DHard4114/DESPRO-4/management/reports/individual/raka/WEEK_01_INDIVIDUAL_RAKA.md

# LAPORAN PEKANAN INDIVIDU — RAKA ARRAYAN MUTTAQIEN (PEKAN 1)
## Despro 2 Smart-Sanitation eSOS

Status Dokumen: TEMPLATE TERKENDALI (CONTROLLED TEMPLATE)  
Nama Mahasiswa: Raka Arrayan Muttaqien  
NPM: 2306161800  
Peran Proposal: Analis Solusi dan Integrasi Layanan (Alokasi: 35 Jam)  
Kelompok: 4 (Empat) | Pekan: 1 (Satu) | Periode: 26 Agustus 2026 – 01 September 2026  
Dosen Pembimbing: Prof. Dr. Muhammad Suryanegara, S.T., M.Sc.  

---

### A. IDENTITAS
- **Judul Proyek:** Rancang Bangun Sistem Monitoring Smart-Sanitation eSOS Berbasis IoT untuk Wilayah Blank Spot Pasca-Bencana
- **Kelompok:** 4 (Empat)
- **Pekan Pelaksanaan:** Pekan 1 (Satu)
- **Periode Waktu:** 26 Agustus 2026 – 01 September 2026
- **Dosen Pembimbing:** Prof. Dr. Muhammad Suryanegara, S.T., M.Sc.

---

### B. TARGET MINGGUAN (PEKAN 1)
- Meninjau spesifikasi teknis proposal DP1 yang terkait domain solusi dan analisis kebutuhan.
- Melakukan verifikasi silang terhadap 15 komponen BoM proposal dan memeriksa ketersediaan pasar.
- Mengidentifikasi variansi harga sensor gas MQ-137/MQ-136 dan menyusun format perbandingan vendor.
- Menyusun dokumen pelacak pengadaan awal (`02_BOM_PROCUREMENT.md`).

---

### C. LOGBOOK AKTIVITAS HARIAN (PEKAN 1: 18.0 JAM)
| Hari / Tanggal | Uraian Aktivitas Operasional | Luaran yang Dihasilkan | ID Bukti | Jam Kerja |
|:---|:---|:---|:---:|:---:|
| Rabu, 26 Agt 2026 | Penelaahan kebutuhan sistem eSOS & standar sanitasi darurat | Dokumen analisis kebutuhan | EV-W1-SA-001 | 3.5 |
| Kamis, 27 Agt 2026 | Verifikasi silang 15 item BoM proposal terhadap katalog pasar | Tabel verifikasi BoM | EV-W1-SA-001 | 4.0 |
| Jumat, 28 Agt 2026 | Identifikasi deviasi harga sensor gas MQ-137 dan MQ-136 | Laporan variansi harga sensor | EV-W1-SA-002 | 3.5 |
| Sabtu, 29 Agt 2026 | Komparasi vendor e-commerce (Shopee/Tokopedia) & seleksi toko | Matriks evaluasi vendor | EV-W1-SA-001 | 3.5 |
| Senin, 31 Agt 2026 | Penyusunan lembar pelacak pengadaan dan persiapan Gate 1 | Dokumen `02_BOM_PROCUREMENT.md` | EV-W1-SA-001 | 3.5 |
| **TOTAL PEKAN 1** | | | | **18.0 Jam** |

---

### D. REALISASI PEKERJAAN
| Kode Tugas | Target Spesifikasi | Realisasi Teknis yang Diselesaikan | Status | ID Bukti |
|:---|:---|:---|:---:|:---:|
| **W1-SA-01** | Analisis kebutuhan sistem | Pemetaan standar sanitasi darurat dan batasan operasional tuntas | `DONE` | EV-W1-SA-001 |
| **W1-SA-03** | Verifikasi silang BoM | 15 item BoM proposal diverifikasi spesifikasi dan fungsinya | `DONE` | EV-W1-SA-001 |
| **W1-SA-05** | Mitigasi risiko pengadaan | Protokol `GATE-PROC-01` s.d. `GATE-PROC-05` ditetapkan | `DONE` | EV-W1-SA-001 |
| **W1-SA-08** | Pelacak pengadaan BoM | Dokumen BoM & tracker terintegrasi dengan batas pagu Rp2.000.000 | `DONE` | EV-W1-SA-001 |

---

### E. CAPAIAN TEKNIS MINGGUAN
- **Luaran Utama:** Dokumen `02_BOM_PROCUREMENT.md` terkunci dan draf Requirements Traceability Matrix (RTM).
- **Rincian Teknis:** Berhasil memetakan kebutuhan 15 komponen fisik, mengidentifikasi vendor terverifikasi, dan menetapkan protokol gerbang teknis kritis sebelum checkout untuk mencegah kesalahan spesifikasi.
- **Penerimaan Teknis:** Dokumen BoM dan RTM disetujui pada evaluasi Phase Gate 1 (PASS).

---

### F. PERMASALAHAN, KENDALA & G. TINDAKAN KOREKTIF
- **Kendala:** Harga pasar riil sensor gas MQ-137 terpantau berada di atas pagu alokasi awal proposal.
- **Tindakan Korektif:** Melakukan survei ke berbagai distributor komponen industri dan memanfaatkan penghematan pada item wiring untuk menjaga total anggaran tetap di bawah batas pagu Rp2.000.000.
- **Hasil:** Struktur pembiayaan aman dan tidak terjadi defisit anggaran.

---

### H. DOKUMENTASI & I. KONTRIBUSI TIM
- **Bukti Terkait:** `EV-W1-SA-001`, `EV-W1-SA-002`, `EV-W1-SA-003`.
- **Kontribusi:** Memastikan kelayakan solusi dan mempersiapkan rantai pasok komponen untuk eksekusi pengadaan Pekan 2.

---

### J. EVALUASI DIRI (SKOR: 25/25 POIN)
- Kehadiran (5/5), Jam Kerja 18h (5/5), Kontribusi Teknis (5/5), Kerja Sama (5/5), Profesionalisme (5/5).

---

### K. RENCANA PEKAN BERIKUTNYA (PEKAN 2)
- Eksekusi pembelian 15 item BoM, verifikasi kedatangan fisik di lab, pengumpulan faktur/resi, dan pembuatan buku aset.

---

### L. PERSETUJUAN
- **Mahasiswa:** Raka Arrayan Muttaqien *(Tanda Tangan)* — Tanggal: 01 September 2026
- **Ketua Kelompok:** Daffa Hardhan *(Tanda Tangan)* — Tanggal: 01 September 2026
- **Dosen Pembimbing:** Prof. Dr. Muhammad Suryanegara, S.T., M.Sc.
