DHard4114/DESPRO-4/management/reports/individual/raka/WEEK_02_INDIVIDUAL_RAKA.md

# LAPORAN PEKANAN INDIVIDU — RAKA ARRAYAN MUTTAQIEN (PEKAN 2)
## Despro 2 Smart-Sanitation eSOS

Status Dokumen: TEMPLATE TERKENDALI (CONTROLLED TEMPLATE)  
Nama Mahasiswa: Raka Arrayan Muttaqien  
NPM: 2306161800  
Peran Proposal: Analis Solusi dan Integrasi Layanan (Alokasi: 35 Jam)  
Kelompok: 4 (Empat) | Pekan: 2 (Dua) | Periode: 02 September 2026 – 08 September 2026  
Dosen Pembimbing: Prof. Dr. Muhammad Suryanegara, S.T., M.Sc.  

---

### A. IDENTITAS
- **Judul Proyek:** Rancang Bangun Sistem Monitoring Smart-Sanitation eSOS Berbasis IoT untuk Wilayah Blank Spot Pasca-Bencana
- **Kelompok:** 4 (Empat)
- **Pekan Pelaksanaan:** Pekan 2 (Dua)
- **Periode Waktu:** 02 September 2026 – 08 September 2026
- **Dosen Pembimbing:** Prof. Dr. Muhammad Suryanegara, S.T., M.Sc.

---

### B. TARGET MINGGUAN (PEKAN 2)
- Mengeksekusi pengadaan 15 komponen BoM resmi selama jendela pengadaan (31 Agt – 05 Sep 2026).
- Mengumpulkan datasheet resmi pabrikan untuk seluruh komponen kritis (ESP32, JSN-SR04T, MQ-137/136, LoRa, 18650).
- Memverifikasi kedatangan fisik barang di laboratorium dan mencatat kuitansi/faktur resmi.
- Membuat buku register aset inventaris proyek dan menyerahkan komponen ke Acceptance Owner.

---

### C. LOGBOOK AKTIVITAS HARIAN (PEKAN 2: 17.0 JAM)
| Hari / Tanggal | Uraian Aktivitas Operasional | Luaran yang Dihasilkan | ID Bukti | Jam Kerja |
|:---|:---|:---|:---:|:---:|
| Rabu, 02 Sep 2026 | Penguncian BoM, pengunduhan datasheet resmi komponen kritis | Arsip PDF datasheet komponen | EV-W1-SA-002 | 3.5 |
| Kamis, 03 Sep 2026 | Eksekusi pesanan komponen kritis (ESP32, sensor, LoRa, modul daya) | Bukti checkout & faktur invoice | EV-W2-PROC-001 | 4.0 |
| Jumat, 04 Sep 2026 | Koordinasi keputusan kapasitas solar panel (10Wp) bersama Ilman | Catatan keputusan solar power | EV-W2-PROC-001 | 3.0 |
| Sabtu, 05 Sep 2026 | Penerimaan paket kurir, unboxing, inspeksi fisik & pelabelan aset | Buku inventaris aset proyek | EV-W2-PROC-002 | 3.5 |
| Senin, 07 Sep 2026 | Rekapitulasi audit pengeluaran keuangan terhadap pagu Rp2.000.000 | Laporan realisasi anggaran | EV-W2-PROC-001 | 3.0 |
| **TOTAL PEKAN 2** | | | | **17.0 Jam** |

**TOTAL AKUMULASI JAM (W1 + W2):** **35.0 Jam** *(100% Target Proposal).*

---

### D. REALISASI PEKERJAAN
| Kode Tugas | Target Spesifikasi | Realisasi Teknis yang Diselesaikan | Status | ID Bukti |
|:---|:---|:---|:---:|:---:|
| **W2-PROC-01** | Penguncian BoM resmi | 15 item BoM terkunci tanpa perubahan sepihak | `DONE` | EV-W1-SA-001 |
| **W2-PROC-02** | Pengarsipan datasheet | 100% berkas datasheet resmi komponen kritis terarsip | `DONE` | EV-W1-SA-002 |
| **W2-PROC-06** | Mitigasi variansi sensor MQ | Protokol `GATE-PROC-01` & `GATE-PROC-02` tuntas dieksekusi | `DONE` | EV-W2-PROC-001 |
| **W2-PROC-10** | Pengumpulan bukti faktur | Seluruh faktur kuitansi pembelian terkumpul pada bundel PDF | `DONE` | EV-W2-PROC-001 |
| **W2-PROC-11** | Registrasi aset inventaris | 100% komponen fisik tiba terdaftar dengan kode aset | `DONE` | EV-W2-PROC-002 |

---

### E. CAPAIAN TEKNIS MINGGUAN
- **Luaran Utama:** Bundel bukti pembelian resmi (`assets/procurement/receipts_bundle.pdf`), arsip datasheet PDF, dan register aset inventaris.
- **Rincian Teknis:** Berhasil merealisasikan pengadaan 15 komponen BoM dengan total Committed Cost $\text{Rp1.945.000}$ (terkendali di bawah batas pagu $\text{Rp2.000.000}$ dan baseline proposal $\text{Rp1.985.000}$). Seluruh 15 komponen telah tiba di lab, lulus uji fisik awal, dan diserahterimakan kepada engineer domain.
- **Penerimaan Teknis:** Kriteria pengadaan Phase Gate 2 dinyatakan lulus (G2.1: PASS).

---

### F. PERMASALAHAN, KENDALA & G. TINDAKAN KOREKTIF
- **Kendala:** Fluktuasi harga pasar sensor gas MQ-137 di toko lokal.
- **Tindakan Korektif:** Memilih distributor resmi komponen industri dengan harga bersaing dan mengalihkan sisa biaya dari penghematan item wiring harness.
- **Hasil:** Pengadaan selesai 100% tepat waktu dengan anggaran tetap surplus.

---

### H. DOKUMENTASI & I. KONTRIBUSI TIM
- **Bukti Terkait:** `EV-W2-PROC-001`, `EV-W2-PROC-002`.
- **Kontribusi:** Mengamankan ketersediaan 100% material fisik proyek tepat waktu sehingga tidak menghambat lini integrasi Pekan 3.

---

### J. EVALUASI DIRI (SKOR: 25/25 POIN)
- Kehadiran (5/5), Jam Kerja 17h (5/5), Kontribusi Teknis (5/5), Kerja Sama (5/5), Profesionalisme (5/5).

---

### K. RENCANA PEKAN BERIKUTNYA (PEKAN 3)
- Monitoring kebutuhan komponen tambahan untuk perakitan casing 3D dan wiring perfboard, audit anggaran Pekan 3.

---

### L. PERSETUJUAN
- **Mahasiswa:** Raka Arrayan Muttaqien *(Tanda Tangan)* — Tanggal: 08 September 2026
- **Ketua Kelompok:** Daffa Hardhan *(Tanda Tangan)* — Tanggal: 08 September 2026
- **Dosen Pembimbing:** Prof. Dr. Muhammad Suryanegara, S.T., M.Sc.
