DHard4114/DESPRO-4/src/firmware/gateway/src/main.cpp

#include <Arduino.h>
#include <SPI.h>
#include <Wire.h>
#include <freertos/FreeRTOS.h>
#include <freertos/task.h>
#include <freertos/queue.h>
#include <freertos/semphr.h>
#include <WiFi.h>
#include <PubSubClient.h>
#include <ArduinoJson.h>
#include <LittleFS.h>
#include <RadioLib.h>
#include <RTClib.h>
#include <ctype.h>
#include <math.h>
#include <stdlib.h>
#include <string.h>
#include "config.h"

// =========================================================================================
// SMART-SANITATION eSOS — GATEWAY ROUTER FIRMWARE (ESP32 DevKit V1)
// Project      : Desain Proyek 2 (Kelompok 4 FTUI - Gasal 2026/2027)
// Framework    : Arduino-ESP32 / ESP-IDF FreeRTOS (Dual-Core Xtensa LX6)
// Hardware     : DOIT ESP32 DevKit V1, SX1278 (Ai-Thinker Ra-02), DS3231 RTC
// Architecture : Single Radio Owner (TaskLoRaRx), Two-Phase Store-and-Forward (LittleFS "r+"),
//                Strict Uplink-Only Alignment, Thread-Safe MQTT Mutex, Non-truncating Buffer,
//                Static IP (192.168.101.11), Dedicated Server Time-Sync Handler.
// =========================================================================================

// ==========================================
// 0. FEATURE FLAGS & CONFIGURATION
// ==========================================
// Tahap operasional saat ini: Uplink-Only.
// Node WC beroperasi transmit-only dan langsung standby (tidak membuka RX window).
// Gateway dinonaktifkan dari memancarkan downlink agar radio tetap siaga RX kontinu.
#define ENABLE_GATEWAY_DOWNLINK     0   // 0 = Nonaktif (Uplink-Only), 1 = Mode Pengembangan

// ==========================================
// 1. OBJEK PERANGKAT KERAS & KERNEL FREERTOS
// ==========================================
static SX1278 radio = new Module(
    PIN_LORA_NSS,
    PIN_LORA_DIO0,
    PIN_LORA_RESET,
    RADIOLIB_NC,
    SPI,
    SPISettings(1000000, MSBFIRST, SPI_MODE0)
);

RTC_DS3231 rtc;
static bool g_rtc_available = false;
static bool g_radio_available = false;
static bool g_fs_available = false;

WiFiClient espClient;
PubSubClient mqtt(espClient);

// Handle FreeRTOS
QueueHandle_t xQueueTelemetry = NULL;
TaskHandle_t  TaskLoRaRxHandle = NULL;
SemaphoreHandle_t fsMutex = NULL;
SemaphoreHandle_t mqttMutex = NULL;
SemaphoreHandle_t rtcMutex = NULL;
static volatile bool g_system_ready = false;

// ==========================================
// 2. TWO-PHASE STORE-AND-FORWARD CIRCULAR BUFFER (LittleFS)
// ==========================================
// Kebijakan Buffer Penuh: OVERWRITE_OLDEST (Drop slot tertua di head jika buffer penuh 500 record).
// Penjaminan: At-Least-Once Delivery. Record dibaca via peekBuffer(), dipublish ke MQTT,
// lalu dihapus via commitBufferDeletion(). Jika publish gagal, record tetap berada di head.
#define MAX_BUFFER_RECORDS  500
#define FILE_META           "/meta.dat"
#define FILE_DATA           "/buffer.dat"
#define BUFFER_MAGIC        0x47574233  // 'GWB3' (Schema v3: GatewayTelemetryRecord 38B)
#define BUFFER_VERSION      3

struct __attribute__((packed)) BufferMeta {
    uint32_t magic;
    uint16_t version;
    uint16_t head;
    uint16_t tail;
    uint16_t count;
    uint32_t dropped_count;
    uint32_t head_seq;      // Nomor urut paket pada posisi head untuk validasi two-phase commit
    uint32_t crc32;
};

struct CommitToken {
    uint16_t slot;
    uint32_t sequence_no;
    bool valid;
};

static BufferMeta meta = {BUFFER_MAGIC, BUFFER_VERSION, 0, 0, 0, 0, 0, 0};

static uint32_t calculateMetaCRC(const BufferMeta &m) {
    uint32_t crc = 0xFFFFFFFF;
    const uint8_t *data = (const uint8_t*)&m;
    size_t length = offsetof(BufferMeta, crc32);
    for (size_t i = 0; i < length; i++) {
        crc ^= data[i];
        for (uint8_t j = 0; j < 8; j++) {
            if (crc & 1) {
                crc = (crc >> 1) ^ 0xEDB88320;
            } else {
                crc >>= 1;
            }
        }
    }
    return crc ^ 0xFFFFFFFF;
}

static bool saveMeta() {
    meta.magic = BUFFER_MAGIC;
    meta.version = BUFFER_VERSION;
    meta.crc32 = calculateMetaCRC(meta);

    File f = LittleFS.open(FILE_META, "w");
    if (!f) {
        Serial.println(F("[LITTLEFS ERROR] Gagal membuka FILE_META untuk penulisan!"));
        return false;
    }
    size_t written = f.write((const uint8_t*)&meta, sizeof(BufferMeta));
    f.flush();
    f.close();

    if (written != sizeof(BufferMeta)) {
        Serial.printf("[LITTLEFS ERROR] Gagal menulis seluruh metadata (%u != %u)\n",
                      (unsigned int)written, (unsigned int)sizeof(BufferMeta));
        return false;
    }
    return true;
}

static void initDataFileIfMissing() {
    if (!LittleFS.exists(FILE_DATA)) {
        File f = LittleFS.open(FILE_DATA, "w");
        if (f) {
            f.close();
            Serial.println(F("[LITTLEFS] Berkas buffer.dat baru berhasil dibuat."));
        } else {
            Serial.println(F("[LITTLEFS ERROR] Gagal membuat buffer.dat baru!"));
        }
    }
}

static void loadMeta() {
    initDataFileIfMissing();
    bool valid = false;

    if (LittleFS.exists(FILE_META)) {
        File f = LittleFS.open(FILE_META, "r");
        if (f) {
            BufferMeta temp;
            if (f.read((uint8_t*)&temp, sizeof(BufferMeta)) == sizeof(BufferMeta)) {
                if (temp.magic == BUFFER_MAGIC && temp.version == BUFFER_VERSION &&
                    temp.crc32 == calculateMetaCRC(temp) &&
                    temp.head < MAX_BUFFER_RECORDS && temp.tail < MAX_BUFFER_RECORDS &&
                    temp.count <= MAX_BUFFER_RECORDS) {
                    
                    // Verifikasi konsistensi ukuran berkas data dengan metadata
                    File dataFile = LittleFS.open(FILE_DATA, "r");
                    if (dataFile) {
                        size_t fileSize = dataFile.size();
                        dataFile.close();
                        if (temp.count == 0 || fileSize >= (size_t)temp.count * sizeof(GatewayTelemetryRecord)) {
                            meta = temp;
                            valid = true;
                        } else {
                            Serial.printf("[LITTLEFS ERROR] Ukuran berkas buffer.dat (%u B) tidak mencukupi untuk %u record!\n",
                                          (unsigned int)fileSize, (unsigned int)temp.count);
                        }
                    }
                } else {
                    Serial.println(F("[LITTLEFS ERROR] Metadata buffer.dat korup atau CRC32 mismatch!"));
                }
            } else {
                Serial.println(F("[LITTLEFS ERROR] Pembacaan metadata terpotong (short read)!"));
            }
            f.close();
        } else {
            Serial.println(F("[LITTLEFS ERROR] Gagal membuka FILE_META untuk pembacaan!"));
        }
    } else {
        Serial.println(F("[LITTLEFS NOTICE] FILE_META belum ada (sistem baru atau belum diinisialisasi)."));
    }

    if (!valid) {
        Serial.println(F("[LITTLEFS] Menginisialisasi metadata baru (Schema v3)..."));
        meta.magic = BUFFER_MAGIC;
        meta.version = BUFFER_VERSION;
        meta.head = 0;
        meta.tail = 0;
        meta.count = 0;
        meta.dropped_count = 0;
        meta.head_seq = 0;
        saveMeta();
    }
}

// ==========================================
// HELPER THREAD-SAFE RTC & METADATA
// ==========================================
static uint32_t getRtcTimestamp() {
    uint32_t epoch = 0;
    if (rtcMutex != NULL && g_rtc_available) {
        if (xSemaphoreTake(rtcMutex, pdMS_TO_TICKS(100)) == pdTRUE) {
            epoch = rtc.now().unixtime();
            xSemaphoreGive(rtcMutex);
        }
    }
    return epoch;
}

static bool setRtcTimestamp(uint32_t epoch) {
    bool ok = false;
    if (rtcMutex != NULL) {
        if (xSemaphoreTake(rtcMutex, pdMS_TO_TICKS(200)) == pdTRUE) {
            if (g_rtc_available || rtc.begin()) {
                rtc.adjust(DateTime(epoch));
                g_rtc_available = true;
                ok = true;
            }
            xSemaphoreGive(rtcMutex);
        }
    }
    return ok;
}

static uint16_t getBufferCount() {
    if (fsMutex == NULL || !g_fs_available) return 0;
    if (xSemaphoreTake(fsMutex, pdMS_TO_TICKS(100)) != pdTRUE) return 0;
    uint16_t count = meta.count;
    xSemaphoreGive(fsMutex);
    return count;
}

// Push data ke flash buffer tanpa pemotongan ("r+" mode)
static bool pushToBuffer(const GatewayTelemetryRecord &record) {
    if (fsMutex == NULL || !g_fs_available) return false;
    xSemaphoreTake(fsMutex, portMAX_DELAY);

    bool success = false;
    if (!LittleFS.exists(FILE_DATA)) {
        initDataFileIfMissing();
    }

    // Buka mode "r+" untuk update posisi acak tanpa truncating berkas lama
    File f = LittleFS.open(FILE_DATA, "r+");
    if (!f) {
        Serial.println(F("[LITTLEFS ERROR] Gagal membuka buffer.dat dalam mode r+ (I/O error, berkas dipertahankan)!"));
        xSemaphoreGive(fsMutex);
        return false;
    }

    uint32_t slot = meta.tail;
    uint32_t offset = slot * sizeof(GatewayTelemetryRecord);
    if (f.seek(offset, SeekSet)) {
        size_t written = f.write((const uint8_t*)&record, sizeof(GatewayTelemetryRecord));
        f.flush();
        if (written == sizeof(GatewayTelemetryRecord)) {
            if (meta.count == 0) {
                meta.head_seq = record.payload.sequence_no;
            }
            meta.tail = (meta.tail + 1) % MAX_BUFFER_RECORDS;
            if (meta.count < MAX_BUFFER_RECORDS) {
                meta.count++;
            } else {
                // Buffer penuh: timpa slot tertua di head (Kebijakan: OVERWRITE_OLDEST)
                meta.head = (meta.head + 1) % MAX_BUFFER_RECORDS;
                meta.dropped_count++;
                Serial.printf("[STORE-AND-FORWARD ALERT] Buffer penuh (%u rekaman). Slot tertua ditimpa! Total dropped: %u\n",
                              MAX_BUFFER_RECORDS, meta.dropped_count);
                // Baca nomor urut record baru yang kini berada di posisi head
                GatewayTelemetryRecord newHead;
                if (f.seek(meta.head * sizeof(GatewayTelemetryRecord), SeekSet)) {
                    if (f.read((uint8_t*)&newHead, sizeof(GatewayTelemetryRecord)) == sizeof(GatewayTelemetryRecord)) {
                        meta.head_seq = newHead.payload.sequence_no;
                    }
                }
            }
            saveMeta();
            success = true;
            Serial.printf("[STORE-AND-FORWARD] Data disimpan ke LittleFS (Slot %u, Antrean: %u, Seq: #%u)\n",
                          slot, meta.count, record.payload.sequence_no);
        } else {
            Serial.println(F("[LITTLEFS ERROR] Penulisan payload tidak lengkap ke flash!"));
        }
    } else {
        Serial.println(F("[LITTLEFS ERROR] Seek gagal pada pushToBuffer!"));
    }
    f.close();

    xSemaphoreGive(fsMutex);
    return success;
}

// Tahap 1 Two-Phase Commit: Peek data pada posisi head tanpa menghapusnya
static bool peekBuffer(GatewayTelemetryRecord *outRecord, CommitToken *outToken) {
    if (fsMutex == NULL || !g_fs_available || outRecord == NULL || outToken == NULL) {
        return false;
    }
    if (xSemaphoreTake(fsMutex, pdMS_TO_TICKS(1000)) != pdTRUE) {
        return false;
    }

    // Validasi meta.count di dalam mutex yang sama
    if (meta.count == 0) {
        xSemaphoreGive(fsMutex);
        return false;
    }

    bool success = false;
    outToken->valid = false;

    File f = LittleFS.open(FILE_DATA, "r");
    if (f) {
        uint32_t slot = meta.head;
        uint32_t offset = slot * sizeof(GatewayTelemetryRecord);
        if (f.seek(offset, SeekSet)) {
            if (f.read((uint8_t*)outRecord, sizeof(GatewayTelemetryRecord)) == sizeof(GatewayTelemetryRecord)) {
                outToken->slot = (uint16_t)slot;
                outToken->sequence_no = outRecord->payload.sequence_no;
                outToken->valid = true;
                success = true;
            } else {
                Serial.println(F("[LITTLEFS ERROR] Short read saat peekBuffer!"));
            }
        }
        f.close();
    } else {
        Serial.println(F("[LITTLEFS ERROR] Gagal membuka buffer.dat untuk peekBuffer!"));
    }

    xSemaphoreGive(fsMutex);
    return success;
}

// Tahap 2 Two-Phase Commit: Hapus logis record setelah MQTT publish berhasil
static bool commitBufferDeletion(const CommitToken &token) {
    if (fsMutex == NULL || !g_fs_available || !token.valid) {
        return false;
    }
    if (xSemaphoreTake(fsMutex, pdMS_TO_TICKS(1000)) != pdTRUE) {
        return false;
    }

    // Validasi meta.count di dalam mutex yang sama
    if (meta.count == 0) {
        xSemaphoreGive(fsMutex);
        return false;
    }

    bool success = false;
    // Verifikasi bahwa posisi head belum berubah atau ditimpa oleh wrap-around
    if (meta.head == token.slot && meta.head_seq == token.sequence_no) {
        meta.head = (meta.head + 1) % MAX_BUFFER_RECORDS;
        meta.count--;
        
        // Perbarui head_seq jika masih ada sisa antrean
        if (meta.count > 0) {
            File f = LittleFS.open(FILE_DATA, "r");
            if (f) {
                GatewayTelemetryRecord nextHead;
                if (f.seek(meta.head * sizeof(GatewayTelemetryRecord), SeekSet)) {
                    if (f.read((uint8_t*)&nextHead, sizeof(GatewayTelemetryRecord)) == sizeof(GatewayTelemetryRecord)) {
                        meta.head_seq = nextHead.payload.sequence_no;
                    }
                }
                f.close();
            }
        }

        saveMeta();
        success = true;
        Serial.printf("[STORE-AND-FORWARD] Commit selesai. Data terkirim di-pop dari Flash. Sisa: %u (Seq: #%u)\n",
                      meta.count, token.sequence_no);
    } else {
        Serial.printf("[STORE-AND-FORWARD NOTICE] Commit dilewati: Slot head telah bergeser (%u != %u) atau seq mismatch (%u != %u). Data telah ditimpa wrap-around.\n",
                      meta.head, token.slot, meta.head_seq, token.sequence_no);
    }

    xSemaphoreGive(fsMutex);
    return success;
}

// ==========================================
// 3. VALIDASI TELEMETRI LORA & KONTRAK DATA
// ==========================================
// Helper validasi float dan batas fisis payload biner
static bool validateTelemetryFloats(const TelemetryPayload &p, char* err_buf, size_t err_len) {
    if (isnan(p.water_level_cm) || isinf(p.water_level_cm)) {
        snprintf(err_buf, err_len, "water_level_cm bernilai NaN/Inf");
        return false;
    }
    if (isnan(p.ammonia_ppm) || isinf(p.ammonia_ppm)) {
        snprintf(err_buf, err_len, "ammonia_ppm bernilai NaN/Inf");
        return false;
    }
    if (isnan(p.h2s_ppm) || isinf(p.h2s_ppm)) {
        snprintf(err_buf, err_len, "h2s_ppm bernilai NaN/Inf");
        return false;
    }
    if (isnan(p.battery_voltage) || isinf(p.battery_voltage)) {
        snprintf(err_buf, err_len, "battery_voltage bernilai NaN/Inf");
        return false;
    }

    // Pengecekan batas rentang nilai (mempertahankan sentinel -1.0f untuk nilai belum terkalibrasi/tersedia)
    if (p.water_level_cm != -1.0f && (p.water_level_cm < 0.0f || p.water_level_cm > 1000.0f)) {
        snprintf(err_buf, err_len, "water_level_cm di luar batas fisis (0..1000 cm): %.1f", p.water_level_cm);
        return false;
    }
    if (p.ammonia_ppm != -1.0f && (p.ammonia_ppm < 0.0f || p.ammonia_ppm > 5000.0f)) {
        snprintf(err_buf, err_len, "ammonia_ppm di luar batas fisis (0..5000): %.1f", p.ammonia_ppm);
        return false;
    }
    if (p.h2s_ppm != -1.0f && (p.h2s_ppm < 0.0f || p.h2s_ppm > 5000.0f)) {
        snprintf(err_buf, err_len, "h2s_ppm di luar batas fisis (0..5000): %.1f", p.h2s_ppm);
        return false;
    }
    if (p.battery_voltage != -1.0f && (p.battery_voltage < 0.0f || p.battery_voltage > 30.0f)) {
        snprintf(err_buf, err_len, "battery_voltage di luar batas fisis (0..30V): %.1f", p.battery_voltage);
        return false;
    }

    return true;
}

// ==========================================
// 4. ISR INTERRUPT DIO0 (HARDWARE RX_DONE) & RADIO RECOVERY
// ==========================================

// ==========================================
// DIAGNOSTIC: DIRECT SX1278 SPI PROBE
// ==========================================

static uint8_t readSX1278Register(uint8_t address) {
    SPI.beginTransaction(
        SPISettings(1000000, MSBFIRST, SPI_MODE0)
    );

    digitalWrite(PIN_LORA_NSS, LOW);

    // MSB = 0: register read.
    SPI.transfer(address & 0x7F);

    uint8_t value = SPI.transfer(0x00);

    digitalWrite(PIN_LORA_NSS, HIGH);

    SPI.endTransaction();

    return value;
}

static bool probeSX1278() {
    for (uint8_t attempt = 1; attempt <= 3; attempt++) {
        uint8_t version = readSX1278Register(0x42);

        Serial.printf(
            "[LORA SPI PROBE] Attempt %u/3 | RegVersion=0x%02X\n",
            attempt,
            version
        );

        // RegVersion SX1276/77/78/79 normalnya 0x12.
        if (version == 0x12) {
            Serial.println(
                F("[LORA SPI PROBE] SX127x terdeteksi melalui SPI.")
            );
            return true;
        }

        delay(20);
    }

    Serial.println(
        F("[LORA SPI PROBE] GAGAL: RegVersion bukan 0x12.")
    );

    Serial.println(
        F("[LORA SPI PROBE] Periksa 3V3, GND, SCK, MISO, MOSI, NSS, RESET.")
    );

    return false;
}

void IRAM_ATTR isr_lora_rx();

static uint8_t s_rx_fail_count = 0;

static bool ensureRadioRxMode() {
    if (!g_radio_available) return false;
    int state = radio.startReceive();
    if (state == RADIOLIB_ERR_NONE) {
        s_rx_fail_count = 0;
        return true;
    }

    Serial.printf("[LORA ERROR] startReceive() gagal (Kode: %d)\n", state);
    s_rx_fail_count++;

    // Jika gagal >= 2 kali berturut-turut (misal: SX1278 brownout drop ke FSK mode -25),
    // lakukan hardware reset dan inisialisasi ulang otomatis agar gateway tidak terjebak mode rusak.
    if (s_rx_fail_count >= 2) {
        Serial.println(F("[LORA RECOVERY] Memulihkan modul SX1278 via Hardware Reset & begin()..."));
        pinMode(PIN_LORA_RESET, OUTPUT);
        digitalWrite(PIN_LORA_RESET, LOW);
        vTaskDelay(pdMS_TO_TICKS(15));
        digitalWrite(PIN_LORA_RESET, HIGH);
        vTaskDelay(pdMS_TO_TICKS(25));

        int init_state = radio.begin(LORA_FREQ, LORA_BW, LORA_SF, LORA_CR, LORA_SYNC_WORD, LORA_TX_POWER);
        if (init_state == RADIOLIB_ERR_NONE) {
            radio.setCRC(true);
            radio.setDio0Action(isr_lora_rx, RISING);
            int rx_state = radio.startReceive();
            if (rx_state == RADIOLIB_ERR_NONE) {
                Serial.println(F("[LORA RECOVERY OK] SX1278 pulih sempurna dan kembali siaga RX Continuous."));
                s_rx_fail_count = 0;
                return true;
            }
        }
        Serial.printf("[LORA RECOVERY ERROR] Re-inisialisasi SX1278 gagal (Kode: %d)\n", init_state);
    }
    return false;
}

void IRAM_ATTR isr_lora_rx() {
    if (TaskLoRaRxHandle != NULL) {
        BaseType_t xHigherPriorityTaskWoken = pdFALSE;
        vTaskNotifyGiveFromISR(TaskLoRaRxHandle, &xHigherPriorityTaskWoken);
        portYIELD_FROM_ISR(xHigherPriorityTaskWoken);
    }
}

// ==========================================
// 5. TASK: PENERIMA LORA RX ASINKRON (Core 1, Prio 3) — SOLE RADIO OWNER
// ==========================================
void vTaskLoRaRx(void *pvParameters) {
    (void)pvParameters;

    // Gerbang Startup: Tunggu setup() selesai sempurna
    while (!g_system_ready) {
        vTaskDelay(pdMS_TO_TICKS(50));
    }

    for (;;) {
        // Blokir dengan batas waktu 5000 ms agar jika interupsi terlewat, radio dapat dipulihkan
        uint32_t notified = ulTaskNotifyTake(pdTRUE, pdMS_TO_TICKS(5000));
        if (notified == 0) {
            // Heartbeat/Watchdog: Pastikan radio tetap siaga mode RX kontinu
            ensureRadioRxMode();
            continue;
        }

        if (!g_radio_available) {
            static uint32_t lastProbeAttempt = 0;
            uint32_t now = millis();
            if ((uint32_t)(now - lastProbeAttempt) >= 10000UL) {
                lastProbeAttempt = now;
                Serial.println(F("[LORA RE-PROBE] Mencoba mendeteksi modul SX1278..."));
                pinMode(PIN_LORA_RESET, OUTPUT);
                digitalWrite(PIN_LORA_RESET, LOW);
                vTaskDelay(pdMS_TO_TICKS(15));
                digitalWrite(PIN_LORA_RESET, HIGH);
                vTaskDelay(pdMS_TO_TICKS(25));
                if (probeSX1278()) {
                    int st = radio.begin(LORA_FREQ, LORA_BW, LORA_SF, LORA_CR, LORA_SYNC_WORD, LORA_TX_POWER);
                    if (st == RADIOLIB_ERR_NONE) {
                        radio.setCRC(true);
                        radio.setDio0Action(isr_lora_rx, RISING);
                        radio.startReceive();
                        g_radio_available = true;
                        s_rx_fail_count = 0;
                        Serial.println(F("[LORA OK] SX1278 berhasil terhubung dan siaga RX Continuous!"));
                    }
                }
            }
            vTaskDelay(pdMS_TO_TICKS(1000));
            continue;
        }

        // 1. Verifikasi panjang paket aktual dari register radio SX1278
        size_t packetLen = radio.getPacketLength();
        if (packetLen != sizeof(TelemetryPayload)) {
            Serial.printf("[LORA RX REJECTED] Ukuran paket tidak sesuai kontrak: %u bytes (diharapkan %u bytes). CRC: RF Hardware Check.\n",
                          (unsigned int)packetLen, (unsigned int)sizeof(TelemetryPayload));
            ensureRadioRxMode();
            continue;
        }

        TelemetryPayload rxData;
        memset(&rxData, 0, sizeof(TelemetryPayload));

        int state = radio.readData((uint8_t*)&rxData, sizeof(TelemetryPayload));
        if (state != RADIOLIB_ERR_NONE) {
            Serial.printf("[LORA RX ERROR] Gagal membaca data radio (Kode: %d)\n", state);
            ensureRadioRxMode();
            continue;
        }

        // 2. Validasi Skema & Flag
        if (rxData.schema_version != 1) {
            Serial.printf("[LORA RX REJECTED] Versi skema tidak dikenal: %u\n", rxData.schema_version);
            ensureRadioRxMode();
            continue;
        }

        if (rxData.sos_triggered > 1) {
            Serial.printf("[LORA RX REJECTED] Status SOS tidak sah: %u\n", rxData.sos_triggered);
            ensureRadioRxMode();
            continue;
        }

        // 3. Validasi & Sanitasi Identitas Node (node_code)
        char safe_node[9] = {0};
        memcpy(safe_node, rxData.node_code, 8);
        safe_node[8] = '\0';

        if (safe_node[0] == '\0') {
            Serial.println(F("[LORA RX REJECTED] node_code kosong!"));
            ensureRadioRxMode();
            continue;
        }

        bool nodeValid = true;
        for (size_t i = 0; i < strlen(safe_node); i++) {
            if (!isalnum((unsigned char)safe_node[i]) && safe_node[i] != '_' && safe_node[i] != '-') {
                nodeValid = false;
                break;
            }
        }
        if (!nodeValid) {
            Serial.printf("[LORA RX REJECTED] node_code mengandung karakter non-printable!\n");
            ensureRadioRxMode();
            continue;
        }

        // 4. Validasi Numerik Float
        char floatErr[80] = {0};
        if (!validateTelemetryFloats(rxData, floatErr, sizeof(floatErr))) {
            Serial.printf("[LORA RX REJECTED] Kontrak data float dilanggar: %s\n", floatErr);
            ensureRadioRxMode();
            continue;
        }

        // 5. Pencatatan Waktu: Simpan Waktu Penerimaan RTC Secara Terpisah (Thread-Safe)
        GatewayTelemetryRecord record;
        record.payload = rxData; // Mempertahankan uptime_seconds asli dari Node WC tanpa overwrite
        record.gateway_timestamp = getRtcTimestamp();

        Serial.printf("[LORA RX] Paket Sah: Node=%.8s | Seq=#%u | Node Uptime=%u s | Gateway Epoch=%u | Air=%.1f cm | Batt=%.2f V | RSSI=%.1f dBm | SNR=%.1f dB\n",
                      safe_node, record.payload.sequence_no, record.payload.uptime_seconds, record.gateway_timestamp,
                      record.payload.water_level_cm, record.payload.battery_voltage,
                      radio.getRSSI(), radio.getSNR());

        // 6. Masukkan ke antrean telemetri RAM.
        // Task LoRa RX HANYA melayani radio dan antrean RAM, DILARANG memblokir operasi flash LittleFS.
        if (xQueueSend(xQueueTelemetry, &record, 0) != pdPASS) {
            Serial.printf("[LORA RX DROPPED] Antrean RAM penuh! Paket Seq #%u di-drop untuk menjaga responsivitas radio.\n",
                          record.payload.sequence_no);
        }

        // Catatan Operasional: Dalam fase Uplink-Only, Gateway TIDAK memancarkan downlink.
        // Radio segera dikembalikan ke mode siaga penerimaan kontinu.
        ensureRadioRxMode();
    }
}

// ==========================================
// 6. TASK: MQTT DISPATCH & STORE-AND-FORWARD (Core 0, Prio 2)
// ==========================================
void vTaskMqttTx(void *pvParameters) {
    (void)pvParameters;

    // Gerbang Startup: Tunggu setup() selesai sempurna
    while (!g_system_ready) {
        vTaskDelay(pdMS_TO_TICKS(50));
    }

    uint8_t ram_serviced_count = 0;

    for (;;) {
        GatewayTelemetryRecord record;
        bool hasData = false;
        bool isFromFlash = false;
        CommitToken flashToken = {0, 0, false};

        // Pengecekan status koneksi MQTT (Thread-safe via mqttMutex)
        bool isMqttOnline = false;
        if (mqttMutex != NULL) {
            xSemaphoreTake(mqttMutex, portMAX_DELAY);
            isMqttOnline = mqtt.connected();
            xSemaphoreGive(mqttMutex);
        }

        // Fair Scheduling: Jika ada backlog di flash dan MQTT online, jangan biarkan
        // paket RAM memonopoli jaringan secara terus menerus (Starvation Prevention).
        // Setiap 2 paket RAM, beri giliran 1 paket flash.
        uint16_t currentBacklog = getBufferCount();
        if (isMqttOnline && currentBacklog > 0 && ram_serviced_count >= 2) {
            if (peekBuffer(&record, &flashToken)) {
                hasData = true;
                isFromFlash = true;
                ram_serviced_count = 0;
            }
        }

        // Jika belum mendapatkan data dari flash, coba ambil dari antrean RAM
        if (!hasData) {
            if (xQueueReceive(xQueueTelemetry, &record, pdMS_TO_TICKS(50)) == pdTRUE) {
                hasData = true;
                isFromFlash = false;
                ram_serviced_count++;
            }
            // Jika RAM kosong dan flash memiliki backlog saat MQTT online
            else if (isMqttOnline && getBufferCount() > 0) {
                if (peekBuffer(&record, &flashToken)) {
                    hasData = true;
                    isFromFlash = true;
                    ram_serviced_count = 0;
                }
            }
        }

        if (hasData) {
            bool published = false;

            if (isMqttOnline && mqttMutex != NULL) {
                xSemaphoreTake(mqttMutex, portMAX_DELAY);
                if (mqtt.connected()) {
#if ARDUINOJSON_VERSION_MAJOR >= 7
                    JsonDocument doc;
#else
                    StaticJsonDocument<384> doc;
#endif
                    doc["schema_version"]  = record.payload.schema_version;

                    char safe_node[9] = {0};
                    memcpy(safe_node, record.payload.node_code, 8);
                    safe_node[8] = '\0';
                    doc["node_code"]       = safe_node;

                    doc["sequence_no"]     = record.payload.sequence_no;
                    // Sesuai kontrak backend Go: field "timestamp" adalah Unix Epoch saat diterima
                    doc["timestamp"]       = record.gateway_timestamp;
                    // Uptime durasi operasional asli dari Node WC tetap dicantumkan
                    doc["uptime_seconds"]  = record.payload.uptime_seconds;
                    doc["water_level_cm"]  = record.payload.water_level_cm;
                    doc["ammonia_ppm"]     = record.payload.ammonia_ppm;
                    doc["h2s_ppm"]         = record.payload.h2s_ppm;
                    doc["battery_voltage"] = record.payload.battery_voltage;
                    doc["sos_triggered"]   = record.payload.sos_triggered;

                    char jsonBuffer[384];
                    size_t jsonLen = serializeJson(doc, jsonBuffer, sizeof(jsonBuffer));

                    // Eksekusi publish MQTT
                    if (mqtt.publish(MQTT_TOPIC_TELEMETRY, (const uint8_t*)jsonBuffer, (unsigned int)jsonLen, true)) {
                        Serial.printf("[MQTT TX] Sukses Publish ke %s (%s): %s\n",
                                      MQTT_TOPIC_TELEMETRY, isFromFlash ? "FLASH" : "RAM", jsonBuffer);
                        published = true;
                    } else {
                        Serial.println(F("[MQTT TX ERROR] Publish gagal ke broker MQTT!"));
                    }
                }
                xSemaphoreGive(mqttMutex);
            }

            // Two-Phase Commit Handling:
            if (isFromFlash) {
                if (published) {
                    // Tahap 2: Commit penghapusan dari LittleFS hanya setelah publish berhasil
                    commitBufferDeletion(flashToken);
                } else {
                    // Publish gagal: data tetap berada di LittleFS head. Dilarang pushToBuffer ulang!
                    Serial.println(F("[STORE-AND-FORWARD] Publish data flash gagal; record dipertahankan di buffer."));
                    vTaskDelay(pdMS_TO_TICKS(500)); // Beri jeda agar tidak retry beruntun tanpa henti
                }
            } else {
                // Data dari RAM yang gagal dipublish disimpan ke LittleFS
                if (!published) {
                    Serial.println(F("[STORE-AND-FORWARD] Publish data RAM gagal/offline; dialihkan ke LittleFS."));
                    pushToBuffer(record);
                }
            }
        }

        vTaskDelay(pdMS_TO_TICKS(50));
    }
}

// ==========================================
// 7. TASK: SUPERVISOR WIFI & MQTT (Core 0, Prio 1)
// ==========================================
void mqttCallback(char* topic, byte* payload, unsigned int length) {
    if (topic == NULL) return;

    // 1. Penanganan Topik Sinkronisasi Waktu Server Backend
    if (strcmp(topic, MQTT_TOPIC_TIMESYNC) == 0) {
        if (length == 0 || length > 32) {
            Serial.println(F("[TIME_SYNC ERROR] Panjang payload time_sync tidak sah."));
            return;
        }

        char time_str[33] = {0};
        memcpy(time_str, payload, length);
        time_str[length] = '\0';

        bool allDigits = true;
        for (size_t i = 0; i < length; i++) {
            if (!isdigit((unsigned char)time_str[i])) {
                allDigits = false;
                break;
            }
        }
        if (!allDigits) {
            Serial.printf("[TIME_SYNC ERROR] Format payload bukan angka bulat sah: '%s'\n", time_str);
            return;
        }

        unsigned long server_epoch = strtoul(time_str, NULL, 10);
        // Validasi epoch waktu masuk akal (antara 1 Nov 2023 [1700000000] hingga tahun 2050 [2500000000])
        if (server_epoch >= 1700000000UL && server_epoch < 2500000000UL) {
            if (setRtcTimestamp((uint32_t)server_epoch)) {
                Serial.printf("[RTC SYNC] RTC DS3231 berhasil disinkronkan ke Epoch Server: %lu\n", server_epoch);
            } else {
                Serial.println(F("[RTC SYNC ERROR] RTC DS3231 offline / tidak merespons di I2C!"));
            }
        } else {
            Serial.printf("[TIME_SYNC ERROR] Nilai epoch di luar rentang sah (1.7B - 2.5B): %lu\n", server_epoch);
        }
        return;
    }

    // 2. Validasi Topik Komando Downlink
    if (strncmp(topic, "esos/", 5) != 0 || strstr(topic, "/command") == NULL) {
        Serial.println(F("[MQTT RX] Pesan diabaikan: Topik tidak dikenal atau di luar namespace esos!"));
        return;
    }

    // 3. Validasi Panjang Payload Komando
    if (length == 0 || length > 256) {
        Serial.println(F("[MQTT RX ERROR] Panjang payload tidak valid (0 atau > 256 byte)."));
        return;
    }

    // 4. Deserialisasi JSON Komando
#if ARDUINOJSON_VERSION_MAJOR >= 7
    JsonDocument doc;
#else
    StaticJsonDocument<256> doc;
#endif
    DeserializationError error = deserializeJson(doc, payload, length);
    if (error) {
        Serial.printf("[MQTT RX ERROR] Format JSON rusak: %s\n", error.c_str());
        return;
    }

    // 5. Wajibkan Seluruh Field & Validasi Tipe Data JSON (DILARANG MENGGUNAKAN NILAI DEFAULT)
    if (!doc["node_code"].is<const char*>() || 
        !doc["command_id"].is<unsigned int>() || 
        !doc["parameter"].is<unsigned int>()) {
        Serial.println(F("[MQTT RX ERROR] Field wajib hilang atau tipe salah (wajib string node_code, integer command_id & parameter)."));
        return;
    }

    const char* node_str = doc["node_code"].as<const char*>();
    size_t node_len = strlen(node_str);
    if (node_len == 0) {
        Serial.println(F("[MQTT RX ERROR] Field node_code kosong!"));
        return;
    }
    if (node_len > 7) {
        Serial.printf("[MQTT RX ERROR] node_code '%s' terlalu panjang (> 7 karakter)! Ditolak tanpa truncating.\n", node_str);
        return;
    }
    for (size_t i = 0; i < node_len; i++) {
        if (!isalnum((unsigned char)node_str[i]) && node_str[i] != '_' && node_str[i] != '-') {
            Serial.printf("[MQTT RX ERROR] node_code '%s' mengandung karakter ilegal!\n", node_str);
            return;
        }
    }

    unsigned int raw_cmd = doc["command_id"].as<unsigned int>();
    if (raw_cmd < 1 || raw_cmd > 4) { // 1: LOCK, 2: UNLOCK, 3: FLUSH, 4: PING
        Serial.printf("[MQTT RX ERROR] command_id %u tidak dikenal (rentang sah: 1..4)!\n", raw_cmd);
        return;
    }

    unsigned int raw_param = doc["parameter"].as<unsigned int>();
    if (raw_param > 255) {
        Serial.printf("[MQTT RX ERROR] parameter %u overflow (> 255)!\n", raw_param);
        return;
    }
    if ((raw_cmd == 1 || raw_cmd == 2) && raw_param > 180) {
        Serial.printf("[MQTT RX ERROR] Sudut servo %u di luar batas (0..180)!\n", raw_param);
        return;
    }

    // 7. Pemisahan Validasi Format dari Status Fitur Downlink
#if !ENABLE_GATEWAY_DOWNLINK
    // Status operasional default: Uplink-Only. Downlink dinonaktifkan secara sadar.
    Serial.printf("[MQTT RX STATUS: DOWNLINK_UNAVAILABLE] Komando valid untuk '%.8s' (CMD=%u, PARAM=%u) DITOLAK.\n",
                  node_str, raw_cmd, raw_param);
    Serial.println(F("   -> Node WC saat ini berjalan dalam mode Uplink-Only (tidak membuka RX window)."));
#else
    // Mode pengembangan downlink (jika diaktifkan via feature flag)
    Serial.printf("[MQTT RX DEV] Komando valid diterima untuk '%.8s' (CMD=%u, PARAM=%u)\n",
                  node_str, raw_cmd, raw_param);
#endif
}

void vTaskWiFiSupervisor(void *pvParameters) {
    (void)pvParameters;

    // Tunggu setup selesai membuat seluruh task dan hardware.
    while (!g_system_ready) {
        vTaskDelay(pdMS_TO_TICKS(50));
    }

    IPAddress localIP(STATIC_IP_LOCAL);
    IPAddress gatewayIP(STATIC_IP_GATEWAY);
    IPAddress subnetMask(STATIC_IP_SUBNET);
    IPAddress dnsIP(STATIC_IP_DNS);
    IPAddress brokerIP;

    if (!brokerIP.fromString(MQTT_SERVER)) {
        Serial.println("[FATAL] MQTT_SERVER bukan alamat IPv4 valid.");
        vTaskDelete(nullptr);
        return;
    }

    WiFi.mode(WIFI_STA);

    if (!WiFi.config(localIP, gatewayIP, subnetMask, dnsIP)) {
        Serial.println("[FATAL] Konfigurasi IP statis gagal.");
        vTaskDelete(nullptr);
        return;
    }

    String clientId = "esos_gateway_" + WiFi.macAddress();
    clientId.replace(":", "");

    // MQTT dipakai task lain: lindungi konfigurasi dengan mutex.
    xSemaphoreTake(mqttMutex, portMAX_DELAY);

    espClient.setTimeout(2); // TCP timeout: 2 s (mencegah task watchdog starvation pada IDLE0)
    mqtt.setSocketTimeout(2);             // MQTT: 2 detik (mencegah loop blocking melebihi batas 5s WDT)
    mqtt.setKeepAlive(30);
    mqtt.setServer(brokerIP, MQTT_PORT);
    mqtt.setCallback(mqttCallback);

    xSemaphoreGive(mqttMutex);

    uint32_t lastWiFiAttempt = 0;
    uint32_t lastMqttAttempt = 0;
    uint32_t mqttRetryMs = 3000;

    bool wifiAttempted = false;
    bool mqttAttempted = false;
    bool wifiLogged = false;

    for (;;) {
        uint32_t now = millis();

        // =====================================
        // 1. Wi-Fi belum tersambung
        // =====================================
        if (WiFi.status() != WL_CONNECTED) {
            if (wifiLogged) {
                Serial.println("[WIFI] Koneksi terputus.");
                wifiLogged = false;

                xSemaphoreTake(mqttMutex, portMAX_DELAY);
                espClient.stop();
                xSemaphoreGive(mqttMutex);
            }

            if (!wifiAttempted ||
                (uint32_t)(now - lastWiFiAttempt) >= 15000UL) {

                Serial.printf("[WIFI] Menghubungi %s...\n", WIFI_SSID);

                WiFi.disconnect();
                WiFi.begin(WIFI_SSID, WIFI_PASS);

                lastWiFiAttempt = millis();
                wifiAttempted = true;
            }

            // Memberi waktu kepada idle task.
            vTaskDelay(pdMS_TO_TICKS(100));
            continue;
        }

        // =====================================
        // 2. Wi-Fi baru tersambung
        // =====================================
        if (!wifiLogged) {
            Serial.printf(
                "[WIFI OK] IP=%s | Gateway=%s | RSSI=%d dBm\n",
                WiFi.localIP().toString().c_str(),
                WiFi.gatewayIP().toString().c_str(),
                WiFi.RSSI()
            );

            wifiLogged = true;
            mqttAttempted = false;
            mqttRetryMs = 3000;
        }

        // Jangan menunggu mutex tanpa kesempatan mengecek ulang.
        if (xSemaphoreTake(
                mqttMutex,
                pdMS_TO_TICKS(100)
            ) != pdTRUE) {

            vTaskDelay(pdMS_TO_TICKS(50));
            continue;
        }

        // =====================================
        // 3. Koneksi MQTT sudah aktif
        // =====================================
        if (mqtt.connected()) {
            mqtt.loop();

            xSemaphoreGive(mqttMutex);
            vTaskDelay(pdMS_TO_TICKS(50));
            continue;
        }

        // =====================================
        // 4. Tunggu jadwal percobaan berikutnya
        // =====================================
        now = millis();

        if (mqttAttempted &&
            (uint32_t)(now - lastMqttAttempt) < mqttRetryMs) {

            xSemaphoreGive(mqttMutex);
            vTaskDelay(pdMS_TO_TICKS(100));
            continue;
        }

        Serial.printf(
            "[TCP] Menghubungi %s:%u...\n",
            MQTT_SERVER,
            (unsigned int)MQTT_PORT
        );

        espClient.stop();
        vTaskDelay(pdMS_TO_TICKS(20)); // Beri kesempatan IDLE0 sebelum operasi socket

        uint32_t started = millis();

        // Koneksi TCP eksplisit dengan timeout 2000 ms (< 5000ms WDT).
        // Menggunakan IPAddress agar tidak memerlukan DNS.
        bool tcpConnected = espClient.connect(
            brokerIP,
            MQTT_PORT,
            2000
        );

        Serial.printf(
            "[TCP RESULT] connected=%d duration=%lu ms\n",
            tcpConnected,
            (unsigned long)(millis() - started)
        );

        bool mqttReady = false;

        if (tcpConnected) {
            // Beri kesempatan IDLE0 berjalan sebelum handshake MQTT.
            // Mutex tetap dipegang agar task lain tidak memakai
            // koneksi TCP yang belum menyelesaikan handshake MQTT.
            vTaskDelay(pdMS_TO_TICKS(30));

            started = millis();

            // PubSubClient menggunakan koneksi TCP yang sudah terbuka.
            bool connected = mqtt.connect(
                clientId.c_str(),
                MQTT_USER,
                MQTT_PASS,
                MQTT_TOPIC_STATUS,
                1,              // QoS Last Will
                true,           // Retained Last Will
                "OFFLINE"
            );

            Serial.printf(
                "[MQTT RESULT] connected=%d state=%d duration=%lu ms\n",
                connected,
                mqtt.state(),
                (unsigned long)(millis() - started)
            );

            // Beri kesempatan IDLE0 berjalan segera setelah handshake MQTT selesai
            vTaskDelay(pdMS_TO_TICKS(20));

            if (connected) {
                // Subscribe dahulu agar respons time-sync
                // setelah ONLINE tidak terlewat.
                bool timeSub = mqtt.subscribe(
                    MQTT_TOPIC_TIMESYNC, 1
                );

                bool commandSub = mqtt.subscribe(
                    MQTT_TOPIC_COMMAND, 1
                );

                if (timeSub && commandSub) {
                    mqttReady = mqtt.publish(
                        MQTT_TOPIC_STATUS,
                        "ONLINE",
                        true
                    );
                }

                if (mqttReady) {
                    Serial.println(
                        "[MQTT OK] Terhubung; subscribe dikirim; ONLINE dikirim."
                    );
                } else {
                    Serial.println(
                        "[MQTT ERROR] Pengiriman subscribe/status gagal."
                    );
                }
            }
        }

        if (!mqttReady) {
            espClient.stop();

            // Backoff maksimum 30 detik.
            mqttRetryMs = mqttRetryMs >= 15000UL
                ? 30000UL
                : mqttRetryMs * 2UL;
        } else {
            mqttRetryMs = 3000;
        }

        lastMqttAttempt = millis();
        mqttAttempted = true;

        xSemaphoreGive(mqttMutex);

        // Wajib ada waktu blocked antarputaran.
        vTaskDelay(pdMS_TO_TICKS(100));
    }
}

// ==========================================
// 8. SETUP UTAMA GATEWAY
// ==========================================
void setup() {
    Serial.begin(115200);
    delay(1000);

    Serial.println();
    Serial.println(F("================================================================="));
    Serial.println(F("  SMART-SANITATION eSOS - GATEWAY ROUTER FIRMWARE (ESP32 DevKit) "));
    Serial.println(F("================================================================="));

    Serial.println(F("[CONFIG] Konfigurasi jaringan & LoRa dimuat dari config.h"));

    // 1. Inisialisasi Mutex & Queues FreeRTOS
    fsMutex = xSemaphoreCreateMutex();
    mqttMutex = xSemaphoreCreateMutex();
    rtcMutex = xSemaphoreCreateMutex();
    xQueueTelemetry = xQueueCreate(50, sizeof(GatewayTelemetryRecord));

    if (fsMutex == NULL || mqttMutex == NULL || rtcMutex == NULL || xQueueTelemetry == NULL) {
        Serial.println(F("[FATAL] Gagal membuat kernel primitives FreeRTOS! Halting."));
        while (1) { vTaskDelay(pdMS_TO_TICKS(1000)); }
    }

    // 2. Inisialisasi Bus I2C RTC DS3231 (SDA:4, SCL:22)
    Wire.begin(PIN_I2C_SDA, PIN_I2C_SCL);
    if (!rtc.begin()) {
        Serial.println(F("[RTC PERINGATAN] Modul RTC DS3231 tidak ditemukan pada I2C!"));
        g_rtc_available = false;
    } else if (rtc.lostPower()) {
        Serial.println(F("[RTC PERINGATAN] DS3231 lost power / osilator berhenti, waktu belum sinkron!"));
        g_rtc_available = false;
    } else {
        Serial.println(F("[RTC OK] Modul RTC DS3231 aktif dan waktu valid."));
        g_rtc_available = true;
    }

    // 3. Konfigurasi buffer PubSubClient (Wajib 512B untuk JSON 384B)
    if (!mqtt.setBufferSize(512)) {
        Serial.println("[FATAL] Alokasi buffer MQTT gagal.");

        // Startup gate belum dibuka.
        while (true) {
            delay(1000);
        }
    }

    // 4. Inisialisasi LittleFS (Store-and-Forward Flash Disk)
    // Gunakan formatOnFail = false agar kegagalan mount tidak menghapus paksa backlog flash
    if (!LittleFS.begin(false)) {
        Serial.println(F("[LITTLEFS ERROR] Mount LittleFS gagal! Data flash dipertahankan tanpa autoformat."));
        Serial.println(F("[LITTLEFS NOTICE] Berjalan dalam mode degraded (RAM buffer only)."));
        g_fs_available = false;
    } else {
        g_fs_available = true;
        loadMeta();
        Serial.printf("[OK] LittleFS aktif. Antrean pesan tersimpan: %u (Dropped: %u)\n", 
                      meta.count, meta.dropped_count);
    }

    // 5. Inisialisasi perangkat keras SX1278.
    // Urutan disamakan dengan Node WC: NSS -> RESET -> SPI -> probe -> RadioLib.

    Serial.println(F("[LORA] Menyiapkan NSS..."));

    pinMode(PIN_LORA_NSS, OUTPUT);
    digitalWrite(PIN_LORA_NSS, HIGH);
    delay(10);

    Serial.println(F("[LORA] Hardware reset SX1278..."));

    pinMode(PIN_LORA_RESET, OUTPUT);
    digitalWrite(PIN_LORA_RESET, LOW);
    delay(20);

    digitalWrite(PIN_LORA_RESET, HIGH);
    delay(100);

    Serial.printf(
        "[LORA] SPI pins: SCK=%d MISO=%d MOSI=%d NSS=%d\n",
        PIN_LORA_SCK,
        PIN_LORA_MISO,
        PIN_LORA_MOSI,
        PIN_LORA_NSS
    );

    SPI.begin(
        PIN_LORA_SCK,
        PIN_LORA_MISO,
        PIN_LORA_MOSI,
        -1
    );

    delay(50);

    // 6. Verifikasi komunikasi SPI secara langsung.
    const bool chipDetected = probeSX1278();

    int state = RADIOLIB_ERR_CHIP_NOT_FOUND;

    if (chipDetected) {
        // Parameter identik dengan Node WC.
        for (int attempt = 1; attempt <= 3; attempt++) {
            Serial.printf(
                "[LORA] RadioLib begin attempt %d/3...\n",
                attempt
            );

            state = radio.begin(
                LORA_FREQ,
                LORA_BW,
                LORA_SF,
                LORA_CR,
                LORA_SYNC_WORD,
                LORA_TX_POWER
            );

            if (state == RADIOLIB_ERR_NONE) {
                break;
            }

            Serial.printf(
                "[LORA] RadioLib begin gagal: %d\n",
                state
            );

            if (attempt < 3) {
                delay(100);
            }
        }
    } else {
        Serial.println(
            F("[LORA] RadioLib begin dilewati: chip tidak terdeteksi via SPI.")
        );
    }

    if (state == RADIOLIB_ERR_NONE) {
        radio.setCRC(true);

        g_radio_available = true;

        Serial.println(
            F("[OK] Radio SX1278 aktif di 433.175 MHz.")
        );
    } else {
        g_radio_available = false;

        Serial.printf(
            "[RADIO ERROR] SX1278 tidak siap. Probe=%s, RadioLib state=%d\n",
            chipDetected ? "0x12 (terdeteksi)" : "bukan 0x12",
            state
        );

        Serial.println(
            F("[RADIO ERROR] Gateway lanjut dalam mode degraded tanpa LoRa.")
        );
    }

    // 7. Peluncuran Task FreeRTOS ke Dual Core ESP32
    // Core 0: Wi-Fi/MQTT Supervisor dan MQTT Dispatcher
    // Core 1: Sole Radio Owner (TaskLoRaRx)
    BaseType_t rWifi = xTaskCreatePinnedToCore(vTaskWiFiSupervisor, "TaskWiFi", 4096, NULL, 1, NULL, 0);
    BaseType_t rMqtt = xTaskCreatePinnedToCore(vTaskMqttTx,         "TaskMqtt", 4096, NULL, 2, NULL, 0);
    BaseType_t rRx   = xTaskCreatePinnedToCore(vTaskLoRaRx,         "TaskLoRaRx", 4096, NULL, 3, &TaskLoRaRxHandle, 1);

    if (rWifi != pdPASS || rMqtt != pdPASS || rRx != pdPASS) {
        Serial.println(F("[FATAL] Gagal meluncurkan Task FreeRTOS Gateway! Halting."));
        while (1) { vTaskDelay(pdMS_TO_TICKS(1000)); }
    }

    // 8. URUTAN INISIALISASI KRITIS:
    // Pasang callback ISR DIO0 dan aktifkan RX Continuous HANYA SETELAH TaskLoRaRxHandle valid!
    // Mencegah hilangnya event interrupt awal akibat handle bernilai NULL.
    if (g_radio_available && TaskLoRaRxHandle != NULL) {
        radio.setDio0Action(isr_lora_rx, RISING);
        if (ensureRadioRxMode()) {
            Serial.println(F("[OK] ISR DIO0 terhubung ke TaskLoRaRxHandle. Radio siaga dalam mode RX Continuous."));
        } else {
            Serial.println(F("[RADIO ERROR] Gagal mengaktifkan mode RX Continuous!"));
        }
    }

    // 9. Buka Startup Gate: Seluruh task sekarang diizinkan mulai berjalan secara harmonis
    g_system_ready = true;
    Serial.println(F("[SYSTEM] Seluruh task diaktifkan via Startup Gate. Gateway siap beroperasi."));
    Serial.println(F("=================================================================\n"));
}

void loop() {
    vTaskDelete(NULL);
}
