DHard4114/DESPRO-4/src/firmware/node_wc/standalone_test/test_mq_sensors/test_mq_sensors.cpp

/**
 * PlatformIO Compilation Bridge for test_mq_sensors.ino
 * 
 * In PlatformIO, this C++ translation unit includes test_mq_sensors.ino.
 * In Arduino IDE, PLATFORMIO is not defined, ensuring this file is completely
 * inert to prevent duplicate symbol collisions (redefinition of setup/loop).
 */
#ifdef PLATFORMIO
#include "test_mq_sensors.ino"
#endif
