DHard4114/DESPRO-4/(commit log)

2026-09-03 feat(init): baseline repository architecture for Smart-Sanitation eSOS
    - Master documentation: WBS 14 weeks, 205-hour RACI matrix, BoM 15 items, RTM, Evidence Register
    - Go backend server: streaming ingestion, batch ETL pipeline, WebSocket hub, UUIDv7 keys, SQLite WAL
    - Static web dashboard: HTML5, Tailwind CSS, Chart.js, real-time telemetry gauges & alerts
    - ESP32 firmware: PlatformIO baseline, sensor drivers (MQ-137, MQ-136, JSN-SR04T), LoRa SX1278
    - CSV spreadsheet templates: 01 Logbook 14 weeks, 02 WBS Gantt, 03 Phase Gate, 04 Test Matrix
    - Directory unification under src/ (bin, config, data, firmware, server)
    [01_DAILY_LOGBOOK_TRACKING.csv, 02_MASTER_WBS_GANTT_CHART.csv, 03_PHASE_GATE_GOVERNANCE.csv, 04_TEST_MATRIX_TC_RTM.csv]
2026-09-03 docs(procurement): clarify collaborative joint procurement by all 5 members
2026-09-03 docs(bom): strictly emphasize No Custom PCB for item 14 perfboard wiring harness
2026-09-05 docs(report): insert catatan pembimbing from prof suryanegara into week 2 reports
2026-09-05 chore(wbs): adjust wbs gantt and phase gate csv templates to reflect checkout delay to week 3
    [02_MASTER_WBS_GANTT_CHART.csv, 03_PHASE_GATE_GOVERNANCE.csv]
2026-09-05 docs(architecture): embed comprehensive mermaid flowcharts and acid compliance mapping across telemetry and frontend architecture layers
2026-09-06 docs(frontend): complete phase 0 revision for actuator ws events, jwt auth, and simulator fallback api updates
2026-09-06 docs(architecture): add Actuator Downlink sequence diagram to MQTT Pipeline [ADR-01]
2026-09-06 docs: finalize low-level architecture hardening (ultrasonic blind zone, packed struct, ISR scheduler, RX window, and env credentials)
2026-09-06 chore(src): zero-trust purge of legacy source code (sqlite, http handlers, single-loop arduino)
2026-09-06 docs: harden power transition stability, SPI clock lock, and ISR debouncing [ADR-09]
2026-09-06 feat(server): phase 0 backend foundations — go.mod, postgres DDL (UUIDv7, 6 tables, LISTEN/NOTIFY), pgxpool connector [ADR-01, ADR-05, ADR-06, ADR-07]
2026-09-06 feat(server): phase 1 & 2 — ETL Pipeline, MQTT Subscriber, REST API, WebSocket Hub, Main Integration
2026-09-06 feat(firmware): phase 3 — LoRa node WC with FreeRTOS, PM locks, strict binary payload [ADR-01, ADR-02, ADR-09]
2026-09-06 feat(firmware): phase 4 — ESP32 Gateway with LittleFS circular buffer & MQTT translator [ADR-01, ADR-04]
2026-09-06 feat(frontend): phase 5 — offline-ready dashboard with native websocket, chart.js, idempotency API calls, slate-950 UI
2026-09-06 fix(server): resolve node_id before batch insert to prevent DB panic during copyfrom
2026-09-06 fix(fatal): seed node_code WC_01 in DB & implement gateway mqtt downlink logic for actuator [ADR-01]
    [main.cpp]
2026-09-06 docs(procurement): update master BOM to 18 items and add GATE-PROC-07 for RTC safety
2026-09-19 docs(reports): update Week 4 report to reflect actual firmware and wiring contributions
2026-09-19 feat(server): mount static dashboard index.html on root route
2026-09-19 feat(telemetry): wire real-time pipeline broadcast to WebSocket hub and fix dummy sequence increments
2026-09-26 docs(report): update week 5 report with accurate target status and battery source root cause
2026-09-28 fix(firmware): audit & overhaul LoRa test & config for ESP32 DevKit V1 and RadioLib
    [config.h, main.cpp, test_lora_receiver.ino, test_lora_standalone.ino]
2026-09-28 fix(receiver): eliminate ISR race condition, add packet length validation, non-blocking queue handling, explicit CRC, and per-node sequence tracking
    [main.cpp, test_lora_receiver.ino, test_lora_standalone.ino]
2026-09-28 fix(receiver): complete engineering overhaul for test_lora_receiver and TX alignment with verified compilation
    [config.h, test_lora_receiver.ino, test_lora_standalone.ino]
2026-09-28 docs(firmware): refine comments on ISR callback registration, task allocation status, and fail-stop cleanup
    [test_lora_receiver.ino, test_lora_standalone.ino]
2026-09-28 feat(diagnostics): add raw SPI probe for RegVersion (0x42) and pass SPI instance to Module
2026-09-28 feat(diagnostics): add MISO pullup electrical probe and multi-register test
2026-09-30 refactor: restructure repository, separate management vs technical docs, implement LoRaWAN Class A pending downlink queue and zero-trust actuator control
2026-09-30 feat(node_wc): implement standalone FreeRTOS test harness and guide for MQ137 and MQ136 sensors
    - Add test_mq_sensors.ino standalone dual gas sensor test harness with FreeRTOS native tasks
    - Implement TaskMQSampler (Core 0, Priority 2) with 16-sample oversampling and EMA filtering
    - Implement TaskMQLogger (Core 0, Priority 1) with non-blocking Serial CLI and NVS calibration persistence
    - Configure isolated [env:test_mq_sensors] in platformio.ini while preserving [env:node_wc]
    - Add comprehensive technical testing guide in STANDALONE_MQ_TEST_GUIDE.md detailing circuit safety, divider math, and Winsen v1.6 specs
2026-09-30 fix(node_wc): address static review findings for standalone MQ test harness
    - Fix stack depth units to bytes (4096 BYTES) for ESP-IDF FreeRTOS compatibility
    - Remove * 4 multiplier on uxTaskGetStackHighWaterMark() (returns bytes in ESP-IDF)
    - Correct R0 definition per Winsen v1.6: R0 is clean air resistance (remove 3.6 constant)
    - Disable unverified PPM estimation until chamber calibration data is available
    - Invalidate Rs and reject calibration upon ADC saturation or abnormal voltages
    - Establish TaskMQSampler as sole owner of configuration, calibration state, and NVS
    - Invalidate baseline R0 upon any divider or RL circuit modification
    - Add input validation for resistors and verify NVS mag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
    [test_mq_sensors.ino]
2026-09-30 fix(node_wc): resolve RL flag ordering bug, NVS stale key removal, and telemetry presentation
    - Set MQ_FLAG_RL_OK immediately after RL configuration validation before evaluating circuit prerequisites
    - Persist explicit validity booleans in NVS and remove stale R0 keys to prevent resurrected invalid calibrations
    - Cache last valid telemetry frame at file scope so CLI 'config' command reliably displays active parameters
    - Disambiguate burst statistics: report ADC_mean (frame burst average) and ADC_ema (interframe smoothed value)
    [test_mq_sensors.ino]
2026-09-30 fix(node_wc): refactor dual MQ sensor harness to v2.2 with atomic NVS record, unified divider validation, and explicit Rs status
    [test_mq_sensors.ino]
2026-10-02 feat(node_wc): implement standalone JSN-SR04T test and integrate MQ137, MQ136, ultrasonic, and LoRa into node_wc
2026-10-02 fix(firmware): complete store-and-forward 2PC, fair scheduling, and sensor diagnostics
    - Gateway: Implement two-phase commit (peekBuffer -> commitBufferDeletion) for LittleFS Store-and-Forward without holding fsMutex during network I/O
    - Gateway: Implement fair scheduler (2 RAM : 1 Flash) to prevent backlog starvation
    - Gateway: Strict MQTT command validation with mandatory fields and DOWNLINK_UNAVAILABLE status
    - Gateway: Strict LoRa telemetry sanity checks (size=34, schema=1, bounds, sentinel preservation)
    - Gateway: Fix startup order (create TaskLoRaRx handle before attaching DIO0 ISR)
    - Node WC: Add SensorCircuitStatus enum and differentiate unconfigured RL from signal invalid
    - Node WC: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
    [main.cpp, test_lora_gateway_rx.ino, test_mq_sensors.ino]
2026-10-10 feat(report, gateway): complete UTS progress report in markdown and apply gateway runtime concurrency fixes
    [config.h, main.cpp]
2026-10-10 fix(gateway): update MQTT_SERVER to laptop IP 192.168.101.100 and add SPISettings with retry loop
    [config.h, main.cpp]
2026-10-10 docs(wbs): add Week 7 individual report, update WBS and evidence register with ping/TCP test proof, and fix gateway network timeouts
    [config.h, main.cpp]
2026-10-31 feat(gateway): finalize node gateway firmware with direct SPI probe, robust startup, and compilation fix
